DO4AS/jufo-project-radiosonde/README.md

# "Jugend Forscht" / "ISEF": radiosonde project

**This project won the national prize at "Jugend Forscht", Germany's largest youth science competition. [In 80 Tagen um die Welt – kleine Sonden auf großer Mission](https://www.jugend-forscht.de/projektdatenbank/in-80-tagen-um-die-welt-kleine-sonden-auf-grosser-mission.html)**

**see https://do4as.github.io/ for more balloon flight information**

---

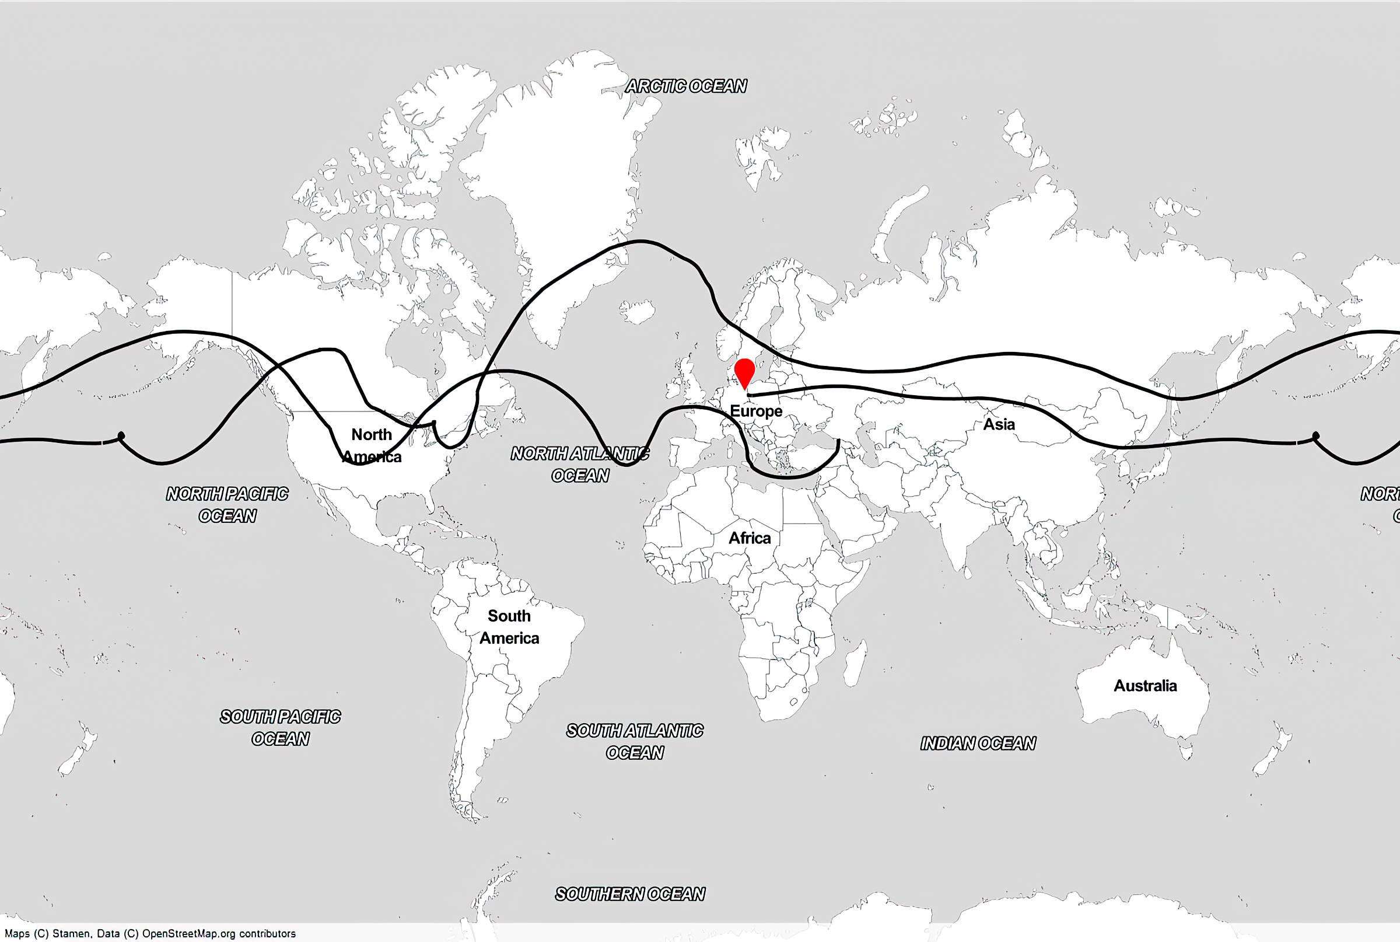
[picture p1: balloon_flight-map-11.png]


### third radiosonde version:

| front view | back view |
| --- | --- |
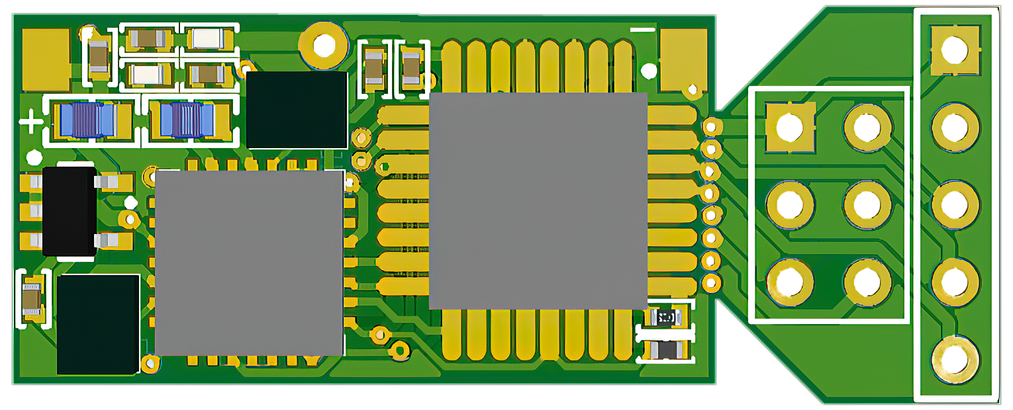
[picture p2: radiosonde-3-lite_front.png]
radiosonde-2-lite_front
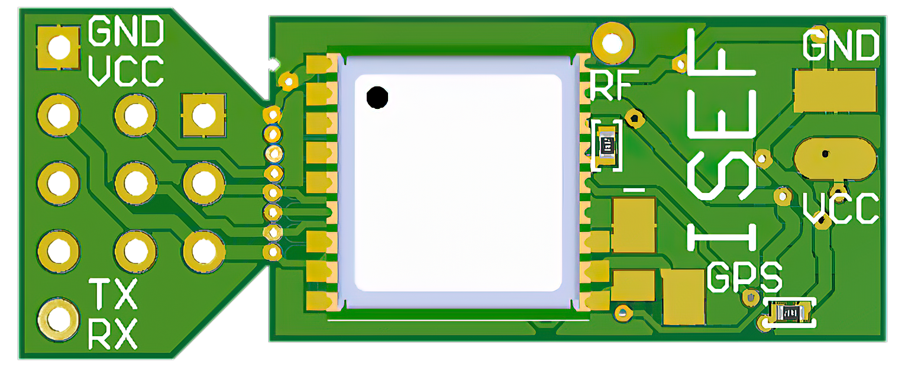
[picture p3: radiosonde-3-lite_back.png]
radiosonde-2-lite_back
|  |  |

radiosonde-3-lite_front_2

**Figure** - radiosonde-3

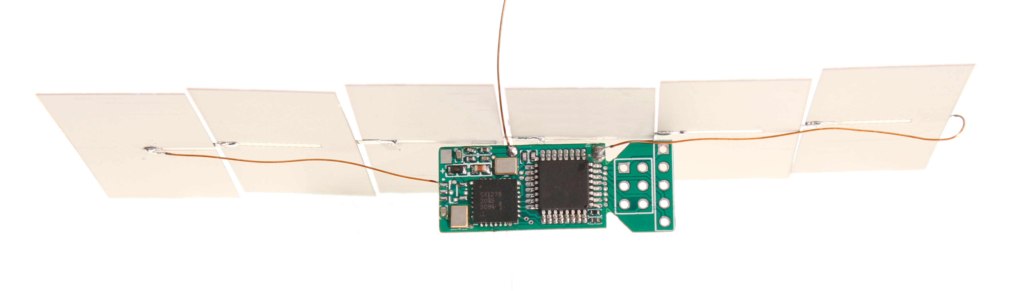
[picture p4: radiosonde-3-lite_with_solar_array.png]


**Figure** - radiosonde-3 with mounted solar panels - radiosonde-3 weighs only 4.8 g

### second radiosonde version with camera:

| aerial image | radiosonde with camera |
|:---:|:---:|
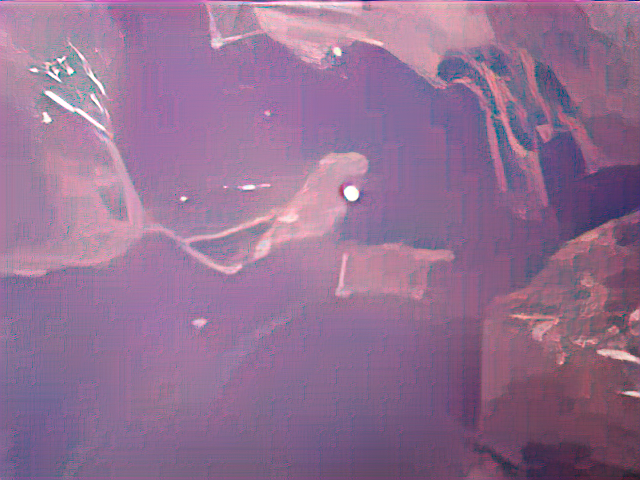
[picture p5: aerial_image_radiosonde_2.png]
aerial_image_radiosonde_2
|  | radiosonde-2-lite_with_camera |

### second radiosonde version:

| front view | back view |
| --- | --- |
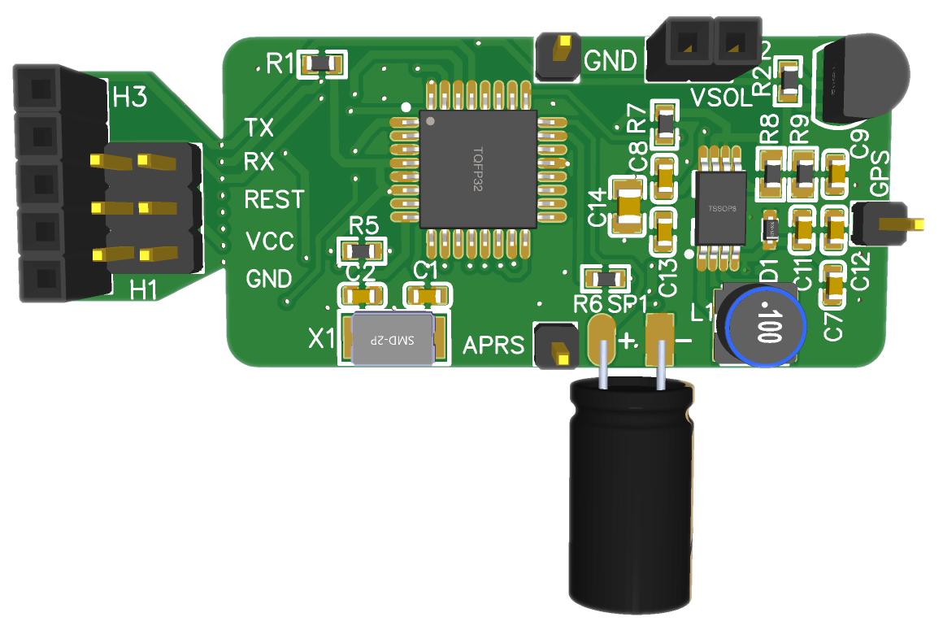
[picture p6: hardware/radiosonde-2/radiosonde-2-lite_front.png]
radiosonde-2-lite_front
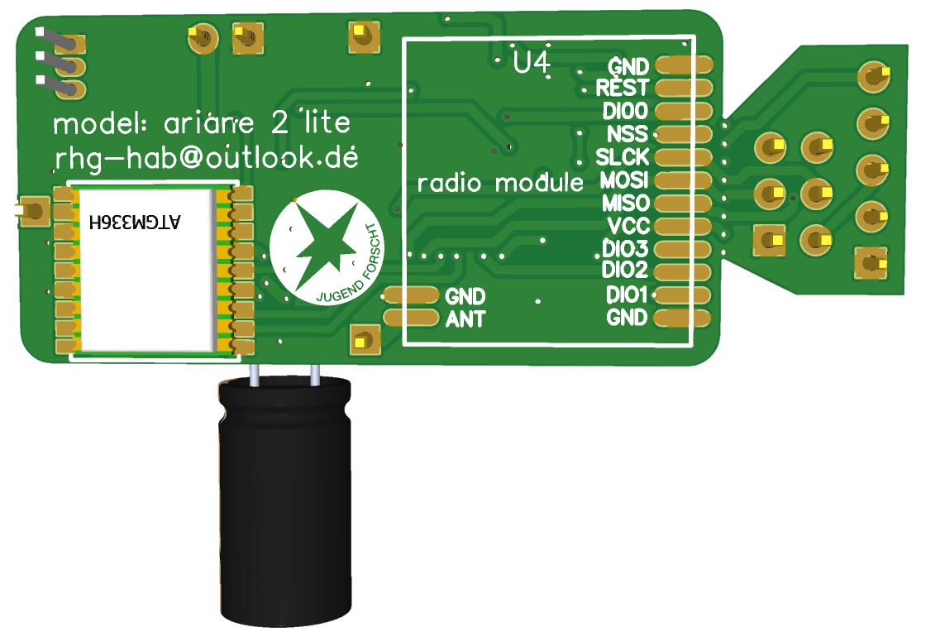
[picture p7: hardware/radiosonde-2/radiosonde-2-lite_back.png]
radiosonde-2-lite_back
|  |  |

 **Figure** - radiosonde-2-lite pcb

radiosonde-2-lite_without_solar_array

 **Figure** - radiosonde-2-lite without mounted solar panels

radiosonde-2-lite_breakouts

**Figure** - radiosonde-2-lite pcb breakout

radiosonde-2-lite_solar_array

**Figure** - radiosonde-2-lite solar panels

radiosonde-2-lite_with_solar_array

**Figure** - radiosonde-2-lite with mounted solar panels - radiosonde-2-lite weighs only 7.8 g

radiosonde-2-lite_with_solar_array_2

**Figure** - radiosonde-2-lite with mounted solar panels from above

### first radiosonde version:

| front view | back view |
| --- | --- |
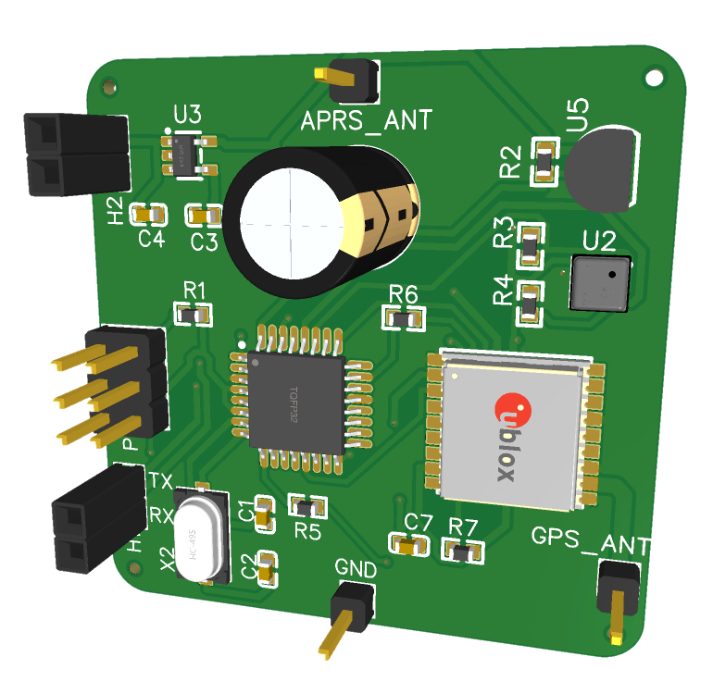
[picture p8: hardware/radiosonde-1/radiosonde-1_front.png]
radiosonde-1_front
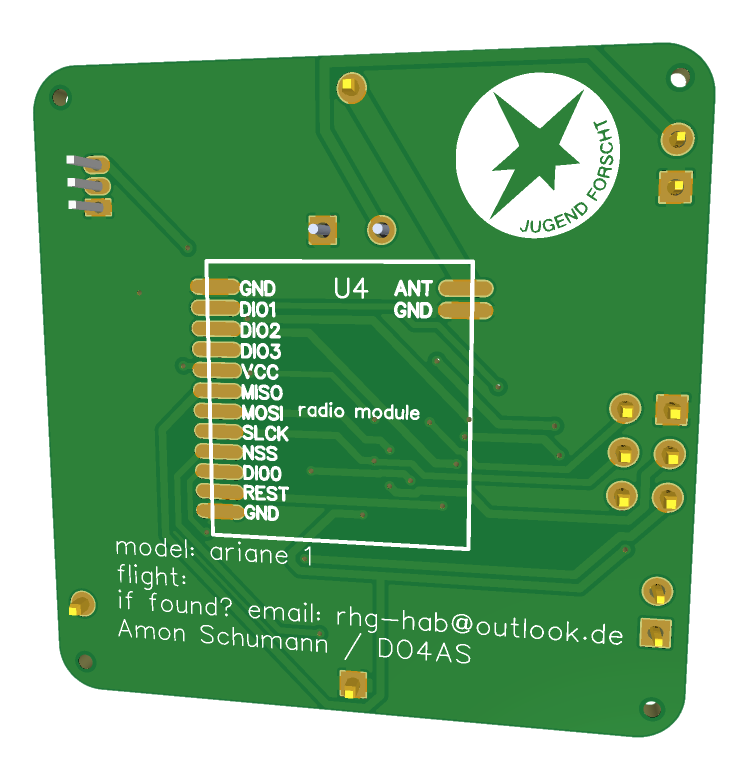
[picture p9: hardware/radiosonde-1/radiosonde-1_back.png]
radiosonde-1_back
|  |  |

 **Figure** - radiosonde-1 pcb

radiosonde-1_without_solar_array**Figure** - radiosonde-1 without mounted solar panels

radiosonde-1_with_solar_array

**Figure** - radiosonde-1 with mounted solar panels

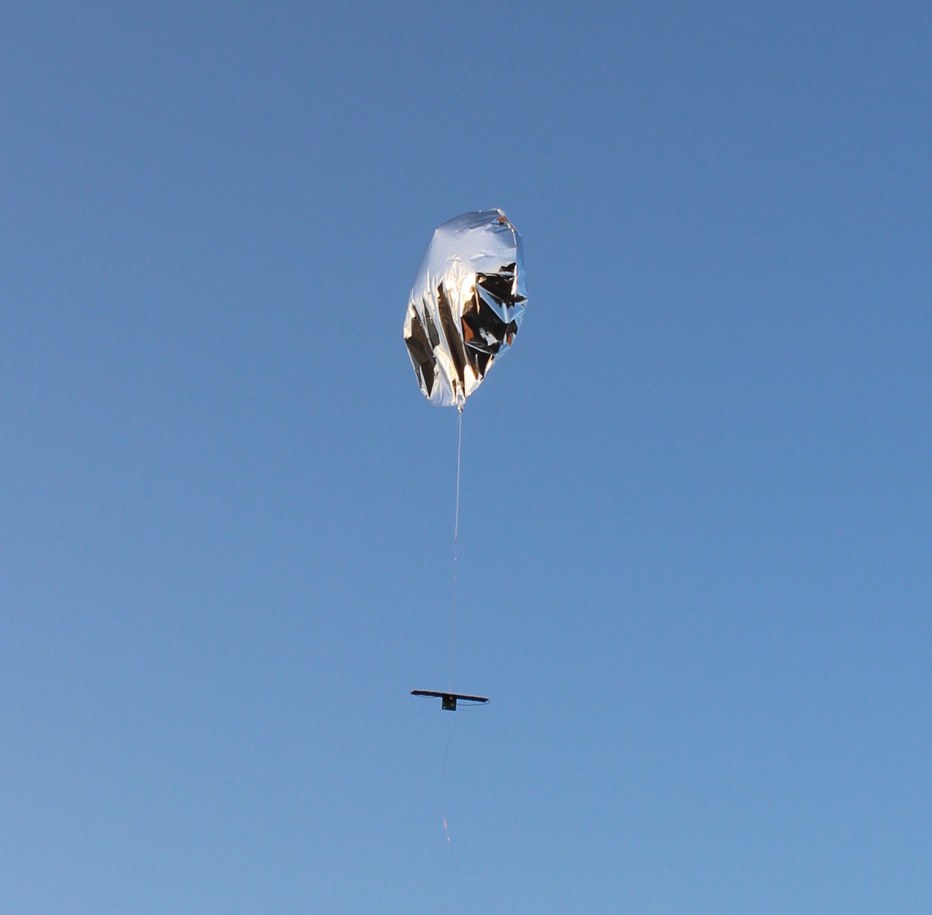
[picture p10: radiosonde-1_in_the_air.jpg]
radiosonde-1_in_the_air


**Figure** - radiosonde-1 in the air

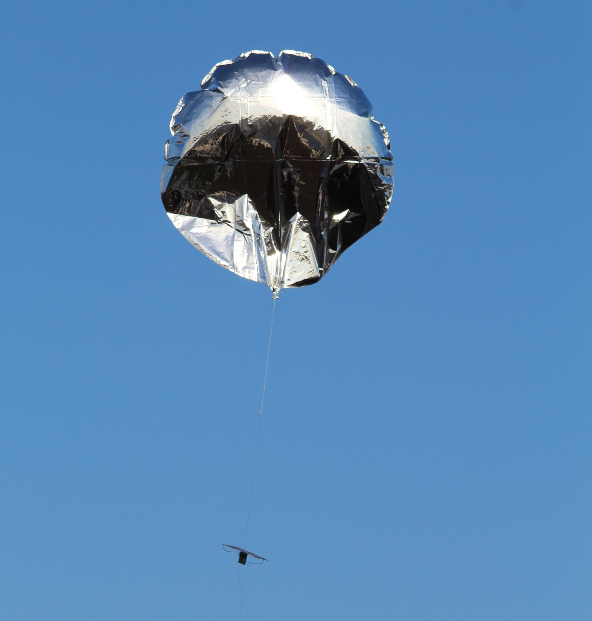
[picture p11: radiosonde-1_in_the_air_2.JPG]
radiosonde-1_in_the_air_2


**Figure** - radiosonde-1 in the air 2

### APRS packet description:

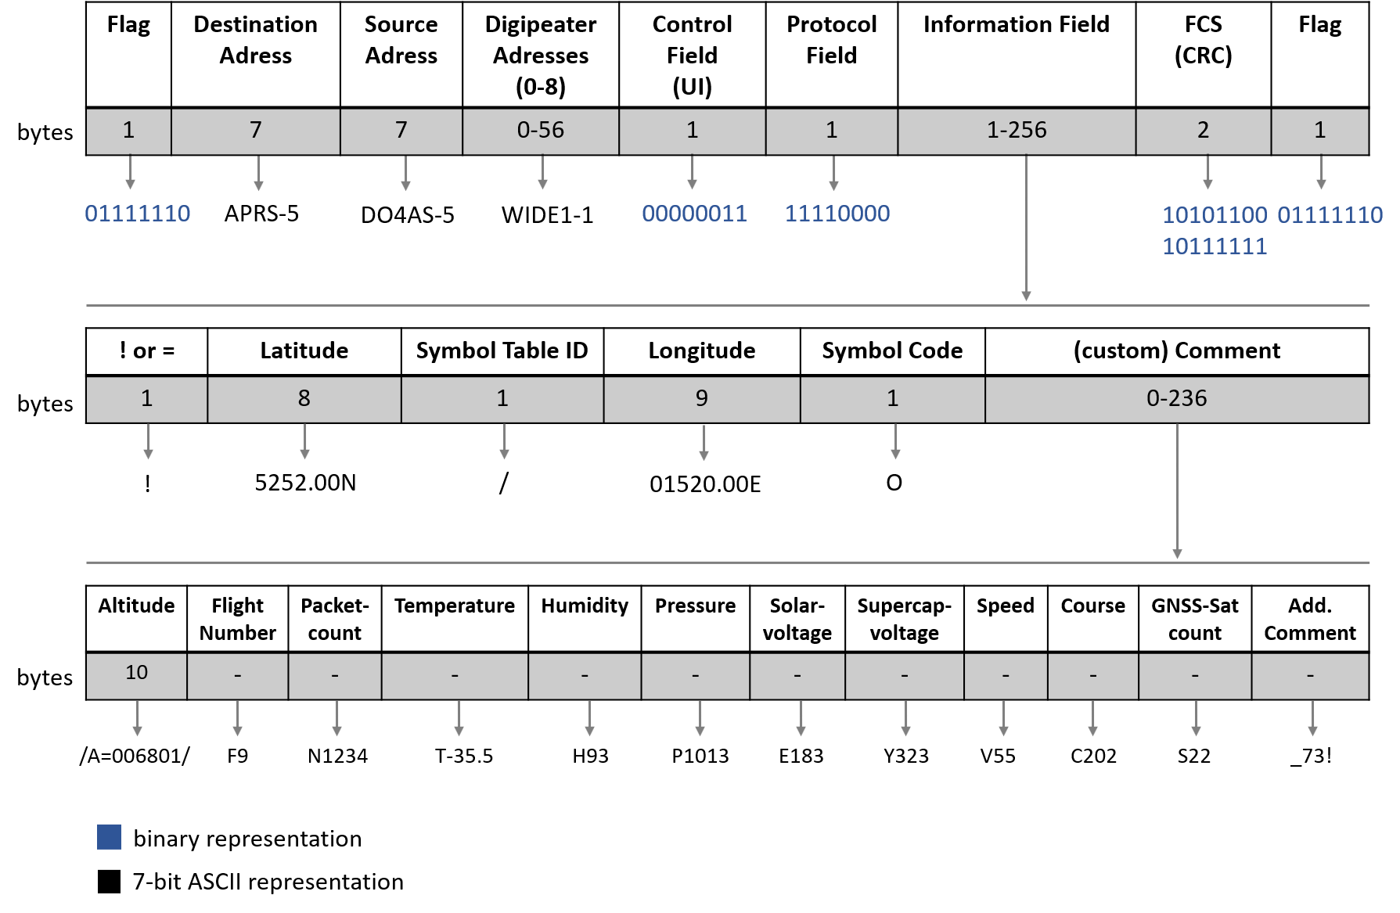
[picture p12: aprs_paket_description.png]
aprs paket description

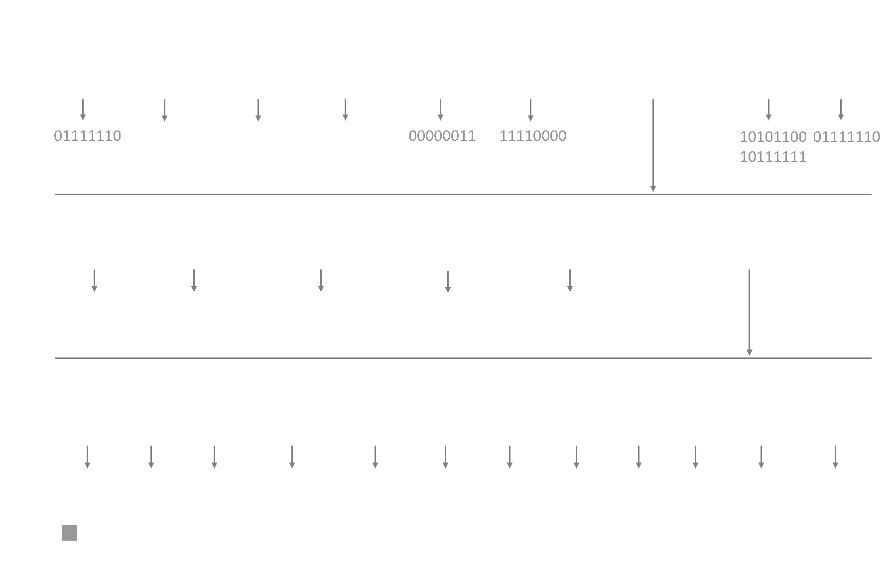
[picture p13: aprs_paket_description_dark.png]
aprs paket description

 **Figure** - APRS packet description

### ascent phase measurement data

ascent profile altitude
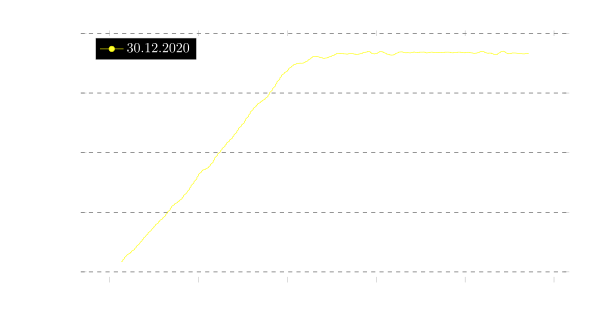
[picture p14: ascent_profile_altitude_dark.png]
ascent profile altitude


**Figure** - radiosonde ascent profile

ascent profile temperature
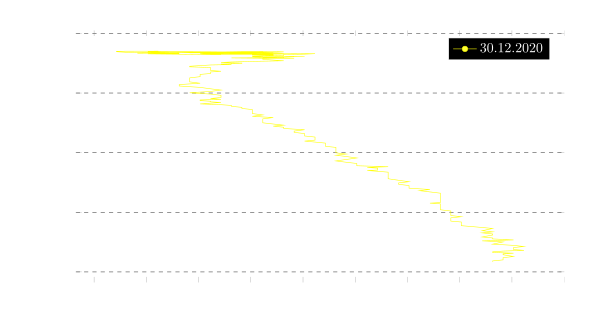
[picture p15: ascent_profile_temperature_dark.png]
ascent profile temperature


**Figure** - radiosonde ascent profile 2

### floating phase measurement data

floating profile altitude
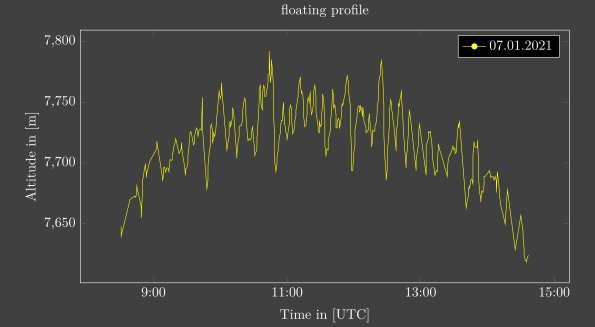
[picture p16: floating_profile_altitude_dark.png]
floating profile altitude


**Figure** - radiosonde floating profile

floating profile temperature
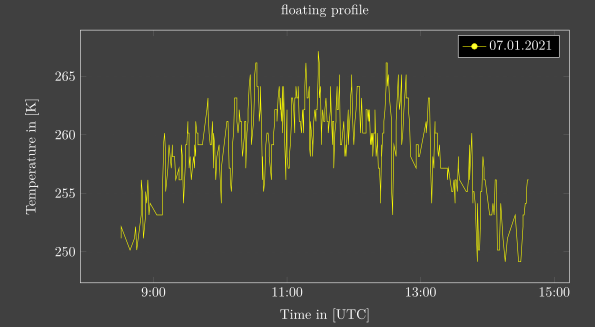
[picture p17: floating_profile_temperature_dark.png]
floating profile temperature


**Figure** - radiosonde floating profile 2
