DO4AS/jufo-project-radiosonde/software/README.md

# "Jugend Forscht": radiosonde project

see https://do4as.github.io/ for more balloon flight information and some balloon calculator utilities

#### program flow chart:



#### program flow chart (in German):
