DO4AS/jufo-project-radiosonde/(threads)

Thread 1 (2021-07-18):

Add support for BME280 sensor if possible ?

zanco, 2021-07-18:
Hi, love the working FM APRS transmitter with the LoRa module. Cheap way to make a balloon payload for testing balloons vs float levels.

I would however like to have BME280 support, the BME680 is quite a bit more expensive and I happen to have 6 BME280 sensors around.

73'
Ben - PE2BZ

DO4AS, 2021-07-19:
Hello Ben,

Thank you for your interest in my repo. The implementation of the BM280 sensor module is likely straight forward. An equivalent library to the BME680 is available for the BME280.

Unfortunately, I am currently on vacation and have very limited access to the internet and arduino compiler. In Addition, I do not have a BME280 to test with. Therefore, I will unfortunately not be able to add this feature in the next few weeks.

 If I get around to implementing this feature anyway, I will answer you.

For now, I encourage you to add this feature yourself.

Best wishes - 73

Amon Schumann - DO4AS

Closed 2023-10-21.

Thread 2 (2021-07-18):

A3 is used twice in the software

zanco, 2021-07-18:
Hi in config.h line 76 A3 is defined as solar_vin_pin

But in aprs.h line 28 A3 is defined as DIO2 pin.

I changed this setting in aprs.h to -1 and it appears to be still working without problems.

Can you confirm that DIO2 is not needed for the APRS transmission ?

Thanks,
Ben = PE2BZ

DO4AS, 2021-07-19:
Hello Ben,

Thanks for posting this issue. In fact, A3 was defined twice. In the latest radiosonde hardware, A3 is actually used to measure solar input voltage.

On some older prototype radiosonde, I used a different library to interface the SX1278 radio chip. A3 was at that time connected to DIO2. DIO2 was defined in aprs.h. To ensure capability, I left this definition in the code. But to avoid further confusion and to clean up the code, I will remove this in the next commit.

Regarding your last question: DIO2 is required in the code. After the migration to the current library, sx1278_radio_pwm_pin in config.h is connected to DIO2. DIO2 is used to generate the LF-modulation of the AFSK signal.

Hope this helps and greetings

Amon Schumann - DO4AS

BTW: Have you already tried to use this code on your hardware? What are your experiences? I would love to know.

zanco, 2021-07-20:
Hi Amon, thanks for your explanation.

Yes, I have built a prototype version, on a Pi Zero "hat" which had space for the GPS module and the SX1278 board and wired the necessary pins to an arduino Pro mini runing at 8 Mhz.

All text below is ment as positive comments ;-)

First conclusion: It works 👍  Somehow I managed to wire GPS output to Arduino TX but nothing happened thereafter.

After changing that I got serial output. That is something I would consider, start serial output by mentioning if either sensor is enabled, check i2c connection to the BME type sensor and print if there is GPS output detected. At this moment the serial output only starts after detecting GPS data which makes debugging a bit harder.

I also think that the GPS altitude is not transmitted if not either one of the sensors is enabled. With the BME enabled but not connected I do not get serial monitor output, so I disabled that one again and enabled the DS18b20. After that I got serial output and the tracker transmits a /Fkhdhfkdhfk telemetry like string and reports altitude on aprs software (and aprs.fi ) too.

The actual sensor temperatue I cannot find back however ?

I would have expected the telemetry string (or single altitude info) to be transmitted too if no sensor was enabled.

Those experiences (except the mixup of GPS TX to arduino TX) are also confirmed by PC4L who built a prototype too.

Now going to study BME280 :-)

Kind regards,
Ben

DO4AS, 2021-07-20:
> I would have expected the telemetry string (or single altitude info) to be transmitted too if no sensor was enabled.

I have opened a new issue for the support of no environment sensor. #3

Closed 2021-07-20.

Thread 4 (2021-09-14):

GPS problem

micked99, 2021-09-14:
Hi, when the balloon gets over 10000m / 30000 feet the altitude starts counting backwards, so a balloon at 11200m transmitts
 (minus) -8800m.

/Mikael  - SA6BSS
mikael_dagman@hotmail.com

Never mid this it was my own stupid misatake :), sorry to have bothered you!!

Tnx for this nice fw! I have made some mods to it and developed 2 pcbs around it, some info in here: https://github.com/micked99/SX1278

ps. check your line:
sprintf(comment_buffer, "/A=%06d/F%dN%dT%dE%dY%dV%dC%dS%d %s" , int((altitude*3.28084)), payload_flight_number, aprs_packet_number, temperature, mcu_vin, solar_vin, gps_speed, gps_course, number_of_gps_satellites, additional_comment.c_str());
 where the int int((altitude*3.28084)) max out at 32,767 ?

DO4AS, 2021-09-14:
Hello Mikael,

thank you for submitting this issue. In fact, there is a problem with a buffer overflow in this version. The altitude is converted from meters to feet for APRS. This value was wrongly stored in a 16-bit integer. The signed 16-bit int goes up to 32767. 32767 feet correspond approximately to 9987m. Therefore, a buffer overflow happened at 9987m.
I have already fixed this bug in the current version but have not yet committed this version. I will commit it soon. Please note that this project is a student project. I have no professional programming experience.

I hope I could help you and remain with friendly greetings

Amon Schumann - DO4AS

BTW: Your PCB design looks very nice. Hope to stay in touch.

Closed 2021-09-14.

Thread 5 (2023-04-14):

Use unique tocall to aid detection and telemetry extraction

darksidelemm, 2023-04-14:
I'm working on adding support to extract some comment-field telemetry to the [SondeHub-Amateur APRS Gateway](https://github.com/projecthorus/sondehub-aprs-gateway/). This will enable display of telemetry along with positions on the sondehub-amateur tracker, as well as having telemetry be available for plotting in our Grafana instance.

Given the plethora of [different comment-field formats](https://xkcd.com/927/) out there, I really need a way to be able to detect what software the APRS packet is originating from to be able to select the appropriate parser. APRS has a mechanism for this in the 'tocall' field, also known as the 'device identified' which for this tracker is currently just set to 'APRS'.

You can read up on how to request a device ID here: https://github.com/aprsorg/aprs-deviceid/#adding-new-devices

Making this change would mean I can add support for your telemetry format, so it can be displayed on the tracker!

DL9AS, 2023-04-14:
Hello, thank you very much for your message! Very gladly, I can request a custom device ID and use it in the software. I am in the process of rewriting the firmware for the radiosondes. Is there anything else I can change about the comment field to make it easier for you to parse?

Kind regards,

Amon Schumann - DL9AS

darksidelemm, 2023-04-14:
As long as it remains consistent (e.g. what you have in your telemetry description is fine!), then it should be fine.

You can see some of the other parsers here: https://github.com/projecthorus/sondehub-aprs-gateway/blob/main/sondehub_aprs_gw/comment_telemetry.py#L47

darksidelemm, 2023-04-15:
I have noticed that the tocalls request don't seem to be getting serviced (lots of open issues on that repo)... I guess try and pick something that isn't in use and hope for the best.

DL9AS, 2023-04-15:
Hello, thanks a lot for your answer. In the long term I will try to request a custom device ID. For now I will use "APAMON". If I see this correctly, this should not in use. For your information, here is the current APRS comment field format:

```
___APRS comment format___

Sample: /A=000000/F0N0T0E0Y0V0C0S0a0b0c0_XYZ

Fixed attributes for every packet:
  /A=[VALUE]/  Altitude [feet]
  F[VALUE]     Flight number
  N[VALUE]     Packet counter
  T[VALUE]     Temperature [deg C]
  E[VALUE]     MCU voltage [V*100]
  Y[VALUE]     Solar voltage [V*100]
  V[VALUE]     Speed [km/h]
  C[VALUE]     Course [deg]
  S[VALUE]     Satellite count

Optional attributes starting lower case [a-z]:
  a[VALUE]     Additional 0
  b[VALUE]     Additional 1
  d[VALUE]     Additional 2
  ...          ...

Optional additional comment
  _[STRING]    Additional comment
```
Kind regards,

Amon Schumann - DL9AS

hessu, 2023-10-16:
Just a short note:

>  V[VALUE]     Speed [km/h]
>   C[VALUE]     Course [deg]

It might be more effective to use the standard APRS course/speed extension (APRS101.PDF page 27) to send speed and course. All standard APRS parsers and devices handle it out of the box without requiring a custom decoder for this transmitter.

DL9AS, 2023-10-17:
I previously had decided not to specify the course and speed as APRS data extension to keep the format consistent. But I also see the big advantage that standard APRS parsers can work with it. I will change this in the next firmware update.

Thanks for all your comments and kind regards,

Amon

DL9AS, 2023-10-21:
I updated the format to specify course and speed as APRS data extension and committed the new firmware.

```
___APRS comment format___

  Sample: 000/000/A=000000/F0N0T0E0Y0S0a0b0c0_XYZ

  Fixed attributes for every packet:
    [VALUE]/[VALUE]   Course [deg] / Speed [knots]
    /A=[VALUE]/       Altitude [feet]
    F[VALUE]          Flight number
    N[VALUE]          Packet counter
    T[VALUE]          Temperature [deg C]
    E[VALUE]          MCU voltage [V*100]
    Y[VALUE]          Solar voltage [V*100]
    S[VALUE]          GNSS-Satellite count

  Optional attributes starting lower case [a-z]:
    a[VALUE]     Additional 0
    b[VALUE]     Additional 1
    d[VALUE]     Additional 2
    ...          ...

  Optional additional comment
    _[STRING]    Additional comment
```

Thank you for all your contributions and kind regards,

Amon Schumann

Closed 2023-10-21.
