DO4AS/jufo-project-radiosonde/(commit log)

2021-07-20 Fixes #2 changed DIO2 pin definition in aprs.h
    [aprs.h]
2021-07-20 Fixes #3 added support for no environmental sensor
    [aprs.cpp, aprs.h]
2021-09-19 Fixes #4 added support for lora ttn network and switch to platformio
    [aprs.cpp, aprs.h, bme680.cpp, bme680.h, config.h, ds18b20.cpp, ds18b20.h, geofence.cpp]
2021-09-26 removed wrong serial print
    [aprs.cpp]
2022-02-11 fixed bug in GNSS coordinates format conversion
    [gps.cpp]
